AurelienCapron/autonomous-ir-projector-remote/docs/presentation_slides.pdf

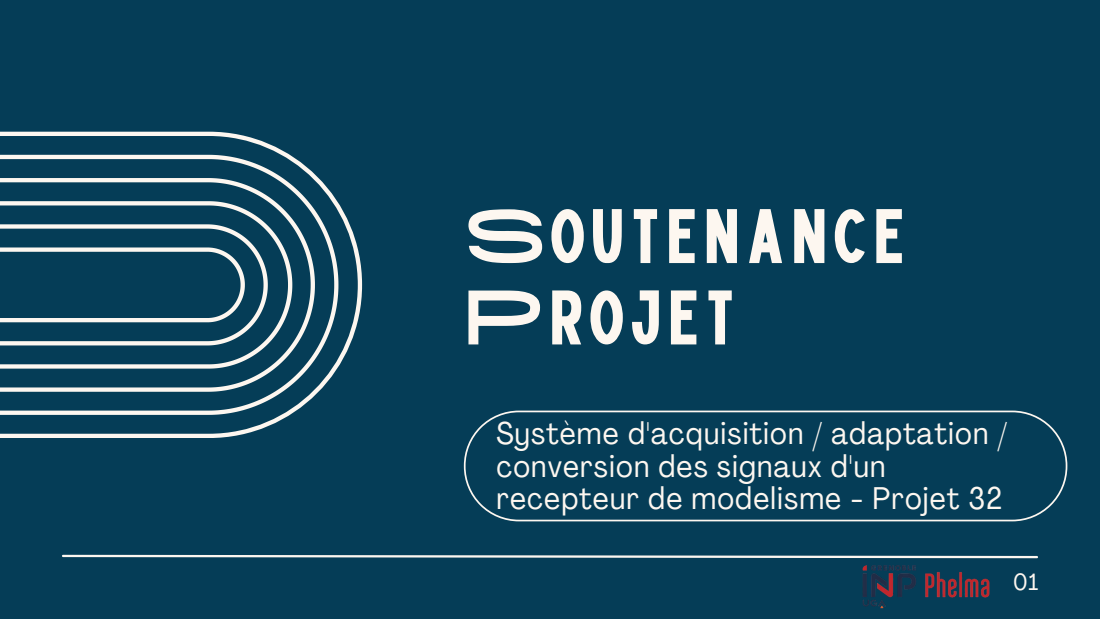
[picture p20: page 1]
Soutenance Projet

Système d'acquisition / adaptation /
conversion des signaux d'un
recepteur de modelisme - Projet 32

# Sommaire

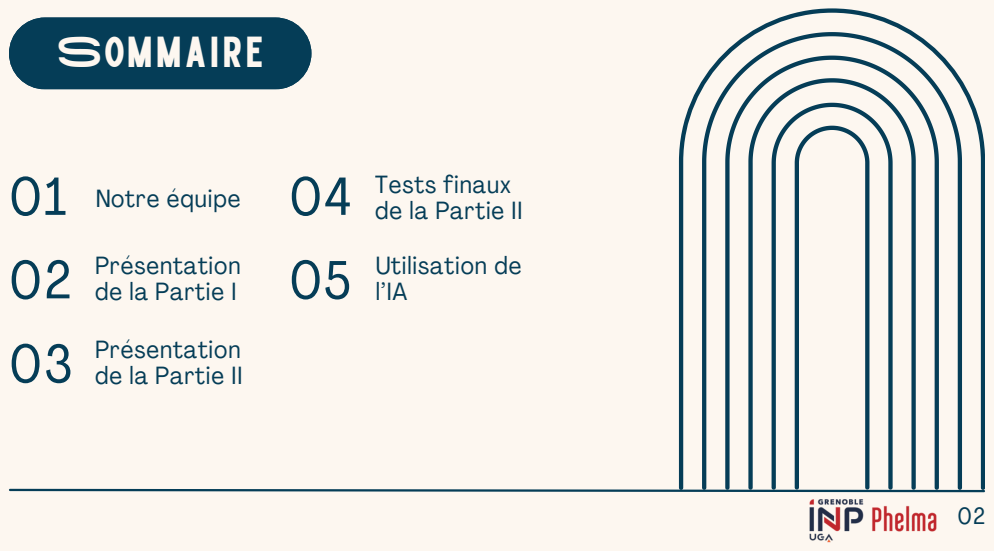
[picture p21: page 2]
Notre équipe; Tests finaux; Utilisation de l’IA

de la Partie II

Présentation
de la Partie I

# Notre équipe partie I

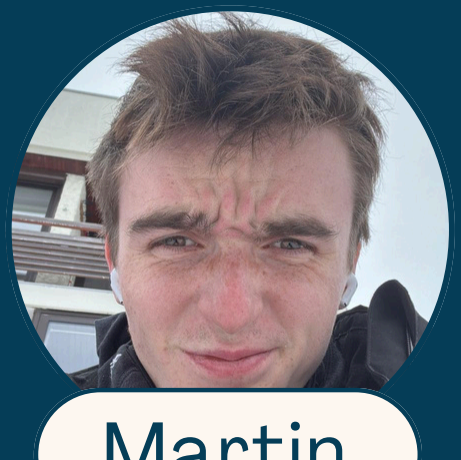
[picture p22: figure]
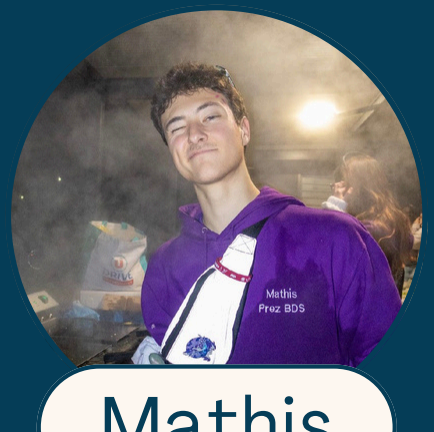
[picture p23: figure]
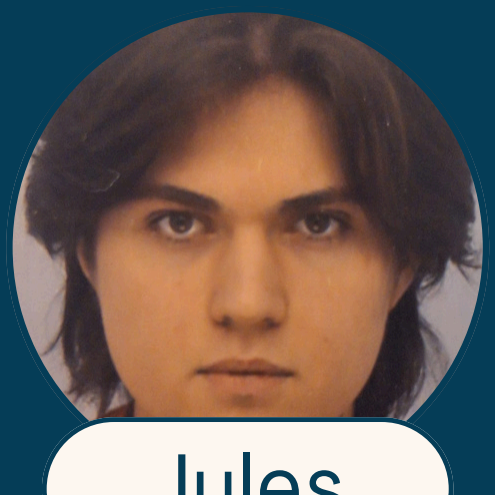
[picture p24: figure]
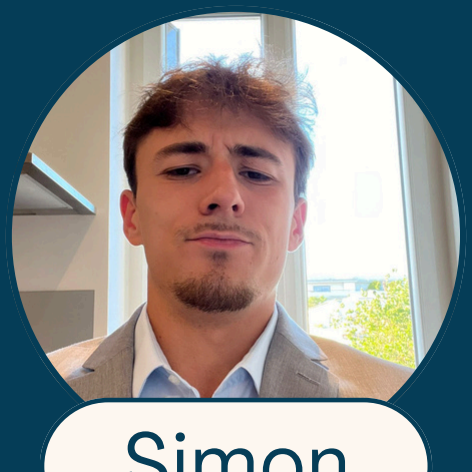
[picture p25: figure]

Martin | Mathis | Jules | Simon

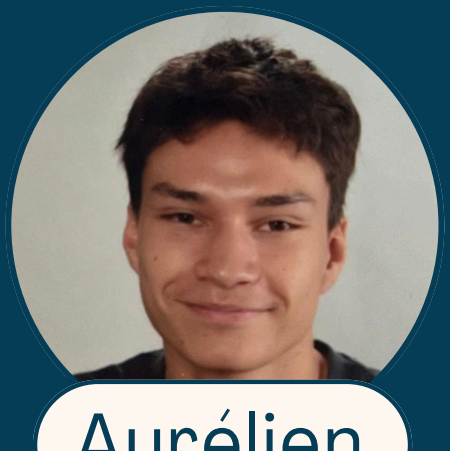
[picture p26: figure]
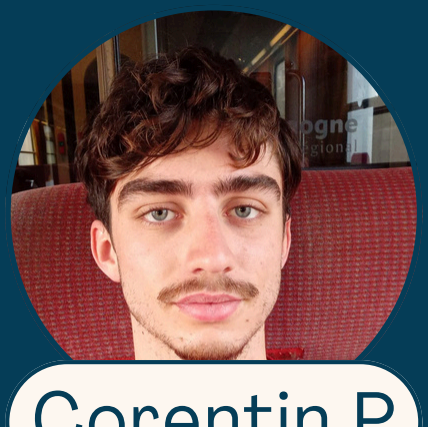
[picture p27: figure]
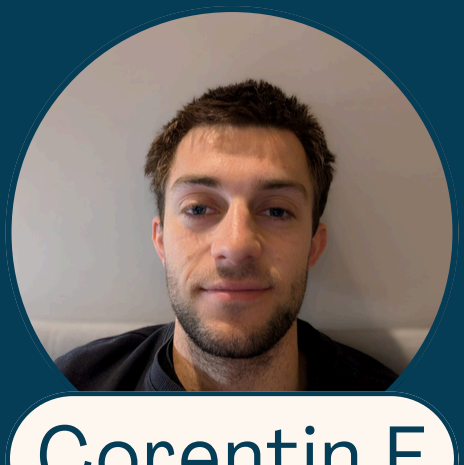
[picture p28: figure]
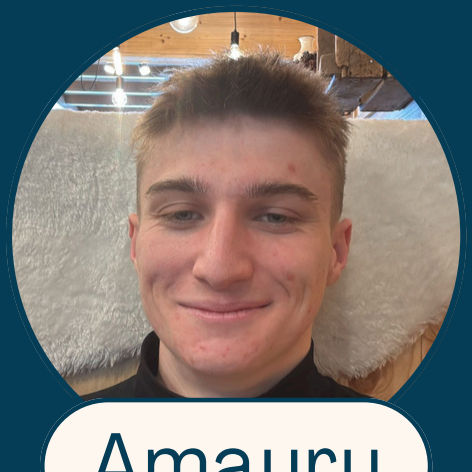
[picture p29: figure]
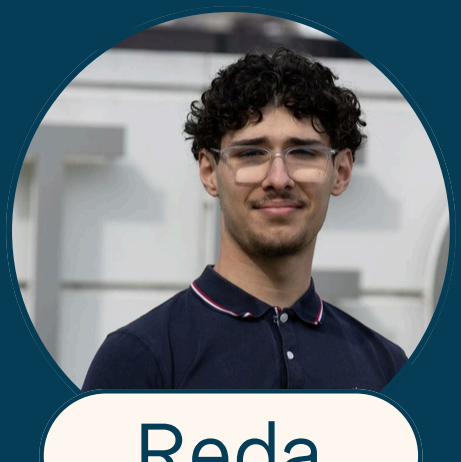
[picture p30: figure]

Aurélien | Corentin P | Corentin E | Amaury | Reda

# Notre équipe partie II

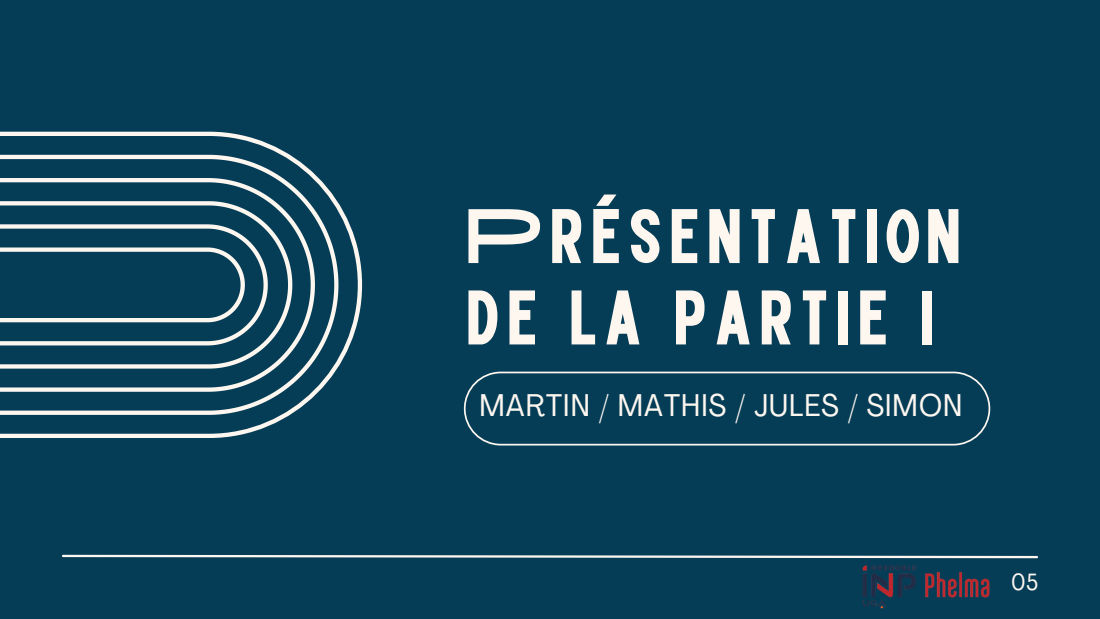
[picture p31: page 5]

Présentation
de la partie I

MARTIN / MATHIS / JULES / SIMON

# Contexte

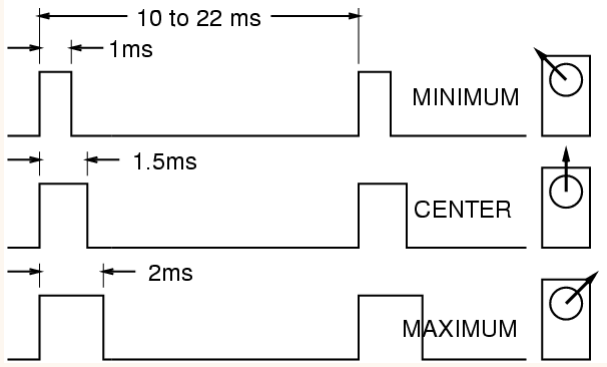
[picture p32: figure]

6

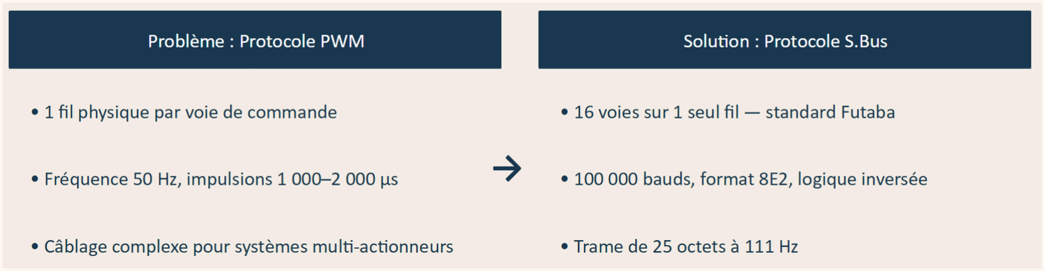
[picture p33: figure]

# Cahier des charges

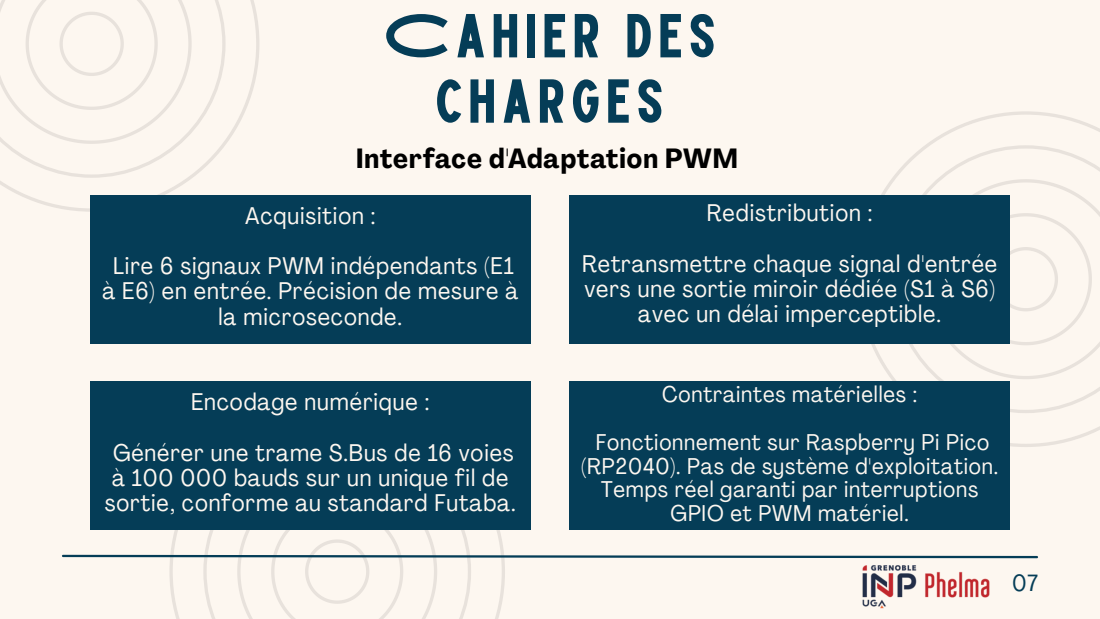
[picture p34: page 7]
Encodage numérique :; Contraintes matérielles :; Acquisition :; la microseconde.; Redistribution :

Interface d'Adaptation PWM

Retransmettre chaque signal d'entrée
vers une sortie miroir dédiée (S1 à S6)
avec un délai imperceptible.

Lire 6 signaux PWM indépendants (E1
à E6) en entrée. Précision de mesure à

Fonctionnement sur Raspberry Pi Pico
(RP2040). Pas de système d'exploitation.
Temps réel garanti par interruptions

Générer une trame S.Bus de 16 voies
à 100 000 bauds sur un unique fil de
sortie, conforme au standard Futaba.

GPIO et PWM matériel.

# Points clés du code :

Interruptions GPIO : attachInterrupt() déclenché sur chaque changement d'état (CHANGE). Mesure de la durée impulsion via micros(). Filtrage des valeurs hors plage [1000 ; 2000] µs.

Une callback par voie : Arduino n'autorise pas de paramètres dans les callbacks d'interruption. Une fonction dédiée par voie (callback_voie_0, callback_voie_1, callback_voie_2) contourne cette contrainte.

Sorties servo : Bibliothèque Servo.h avec writeMicroseconds() pour piloter directement en µs. Signal PWM 50 Hz généré en hardware, sans charge CPU.

Encodage S.Bus : Conversion linéaire PWM→11 bits par voie, empilement bit à bit sur 25 octets, inversion logique ~trame[i] et envoi Serial1 à 100 000 bauds 8E2.

8

# Explication du code :

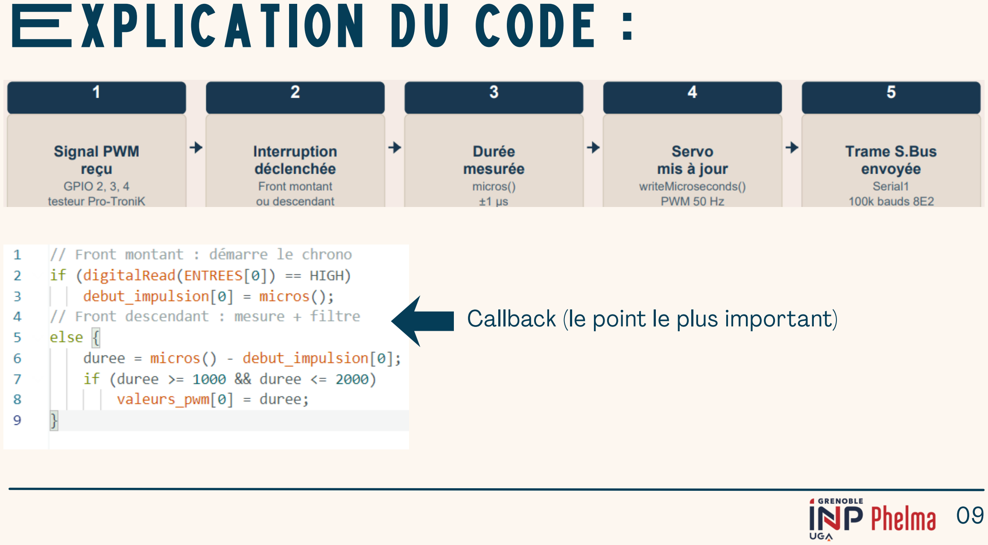
[picture p35: page 9]

Callback (le point le plus important)

9

# architecture de l’expérience

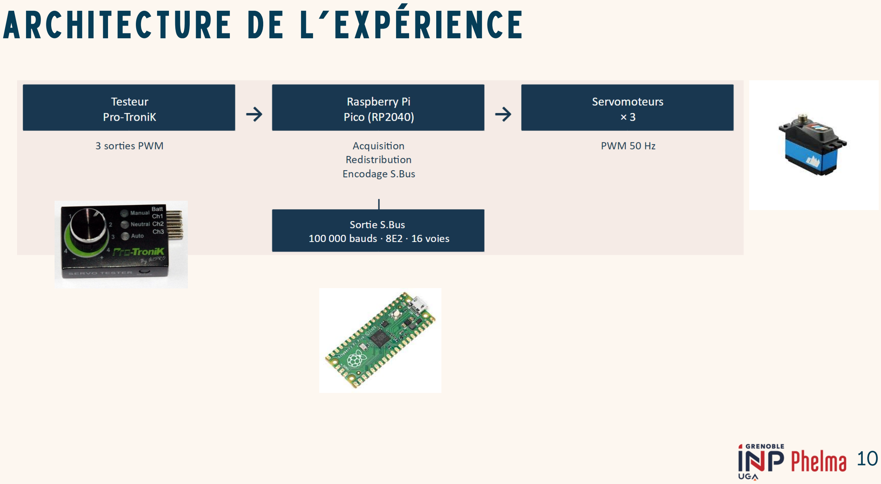
[picture p36: page 10]

10

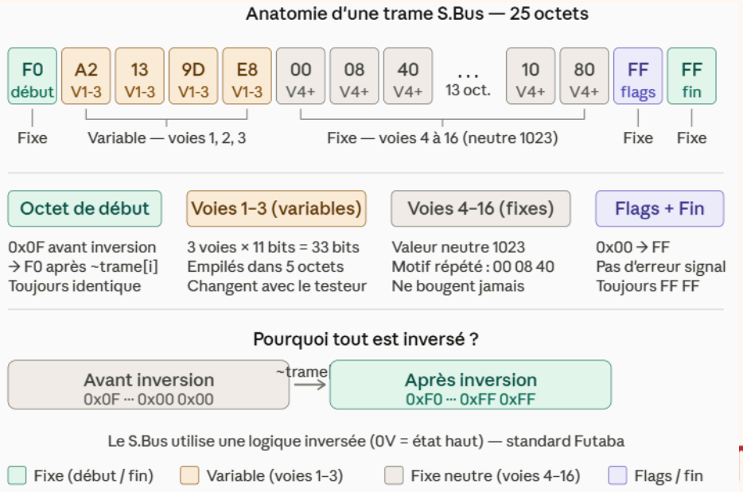
[picture p37: figure]

Étape | Action / Opération | Illustration Binaire / Hexa | Valeur Décimale
1. Poids faible (8 bits) | Lecture de l'Octet 1 | 0x5D | 93
2. Poids fort (3 bits) | Extraction sur l'Octet 2 | 1110 1100 → on garde 100 | 4
3. Alignement | Décalage à gauche (<< 8) | Multiplication par 28 (4* 256) | 1024
4. Résultat Voie 1 | Fusion des deux parties | | 93 + 1024 = 1117

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
# uin

o

V

ale

u

r

minim

ale : Valeur neutre : Valeur maximale : | 1

1

# vérification des résultats

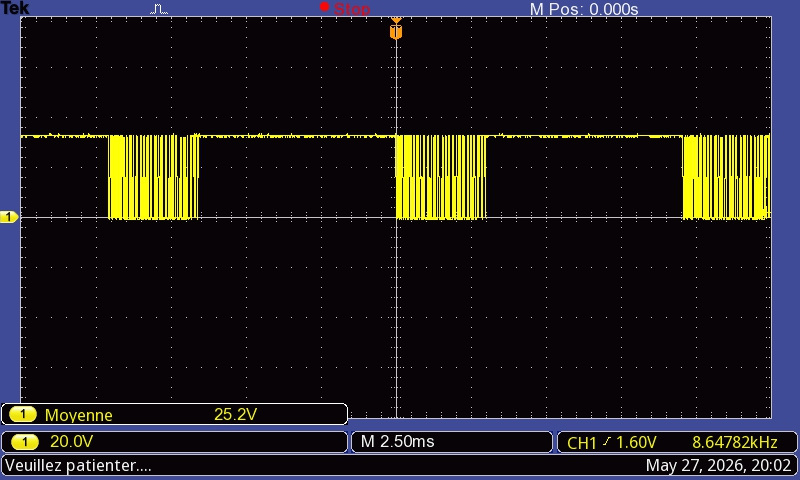
[picture p38: figure]
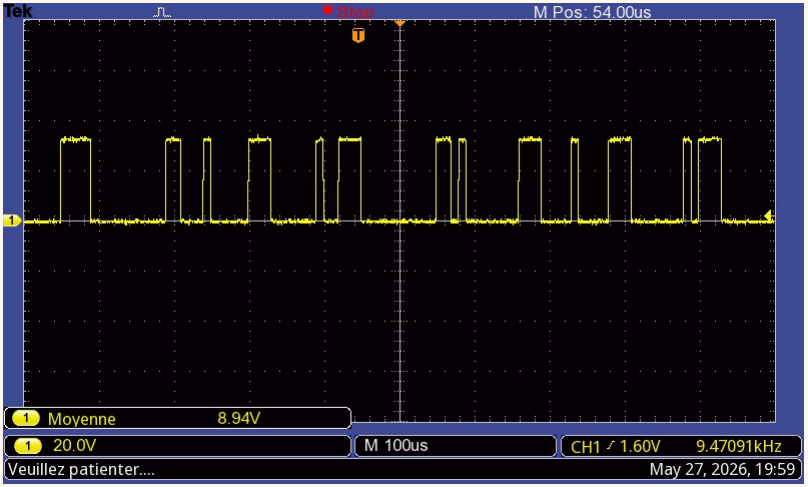
[picture p39: figure]

Points clés :
Base de temps oscilloscope : 100 µs / division Configuration matérielle (Pico) : UART S.Bus à 100 000 bauds Preuves mathématiques :
Durée d'un bit sur la ligne : 1/100000 = 10 µs Durée totale d'un octet S.Bus : 12 bits × 10 µs = 120 µs
L'encodage matériel du microcontrôleur est parfaitement aligné sur la norme.

Points clés :
Base de temps oscilloscope : 2,50 ms / division Observations physiques :
Espacement entre deux trames : environ 3,6 divisions Largeur d'un bloc de données : environ 1,2 divisions Preuves mathématiques :
Période de rafraîchissement mesurée : 3,6 div × 2,5 ms/div = 9 ms (Conforme au standard)
Temps de transmission théorique (25 octets, format 8E2 = 12 bits/octet) : (25*12)/100000 = 3ms (Correspond à la largeur d'1,2 division mesurée à l'écran)

12

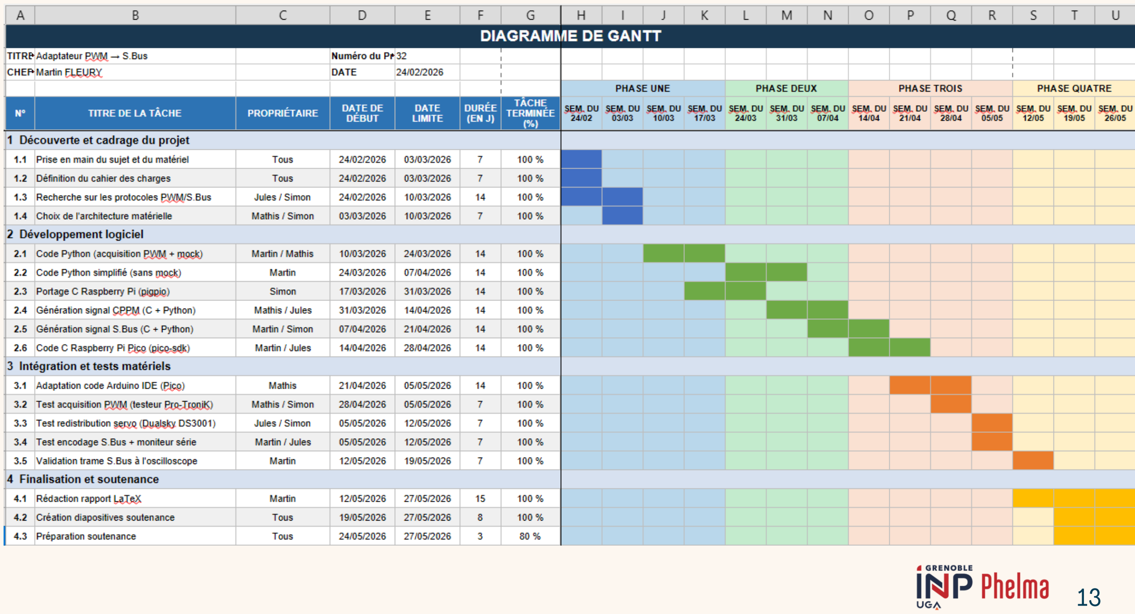
[picture p40: page 13]

13

# conclusion partie 1 :

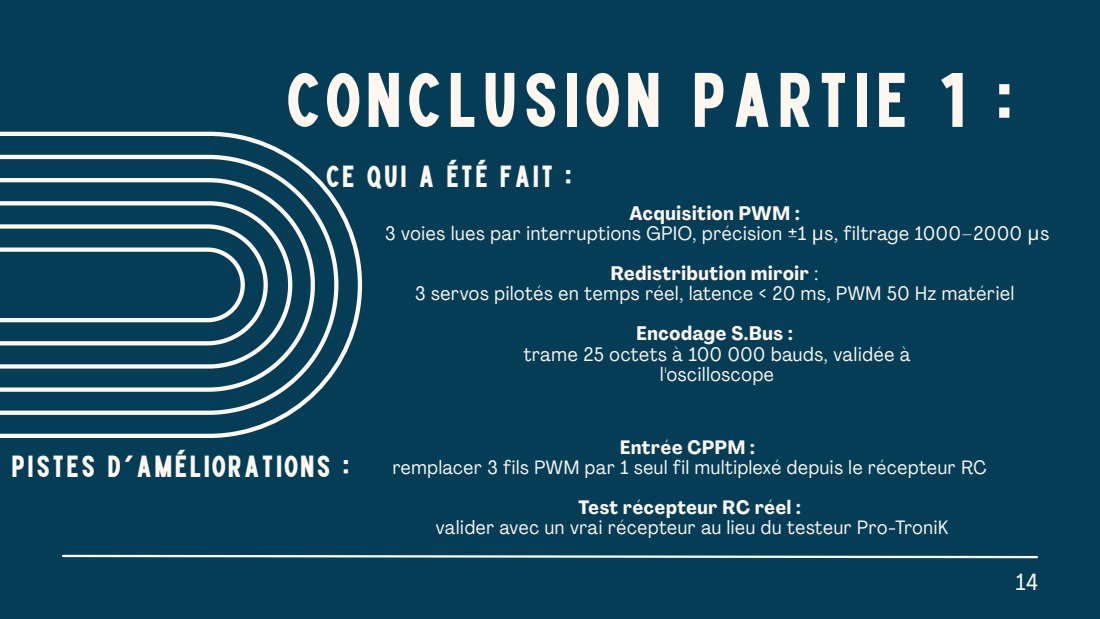
[picture p41: page 14]
Acquisition PWM :; Redistribution miroir :; Encodage S.Bus :; l'oscilloscope; pistes d’améliorations :; Entrée CPPM :

ce qui a été fait :

3 voies lues par interruptions GPIO, précision ±1 µs, filtrage 1000–2000 µs

3 servos pilotés en temps réel, latence < 20 ms, PWM 50 Hz matériel

trame 25 octets à 100 000 bauds, validée à

remplacer 3 fils PWM par 1 seul fil multiplexé depuis le récepteur RC

Test récepteur RC réel :

valider avec un vrai récepteur au lieu du testeur Pro-TroniK

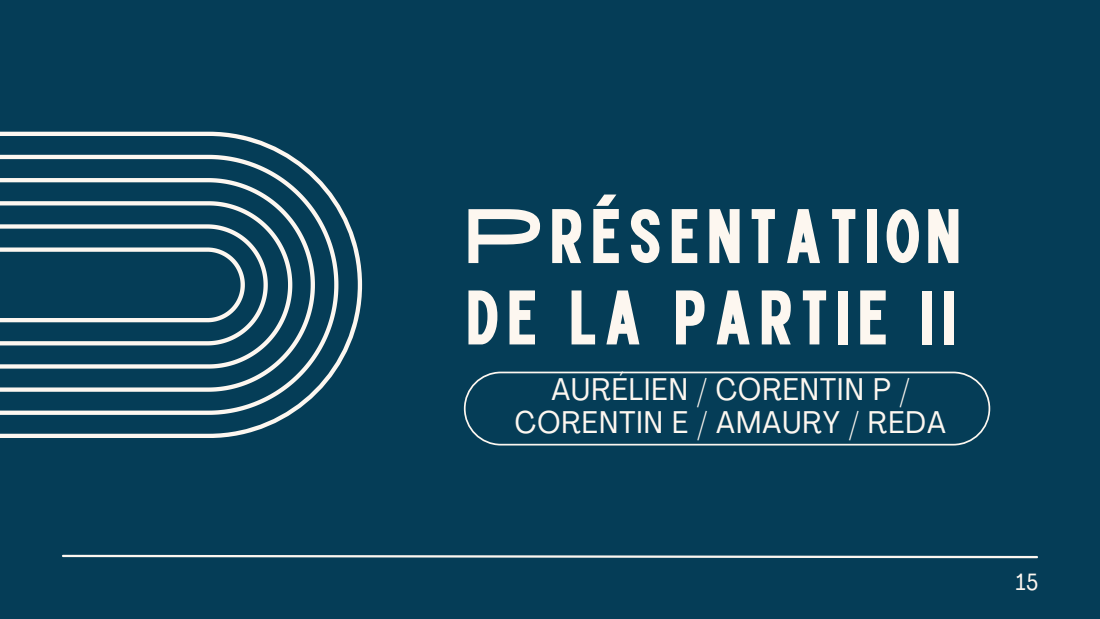
[picture p42: page 15]

Présentation
de la partie II

AURÉLIEN / CORENTIN P /
CORENTIN E / AMAURY / REDA

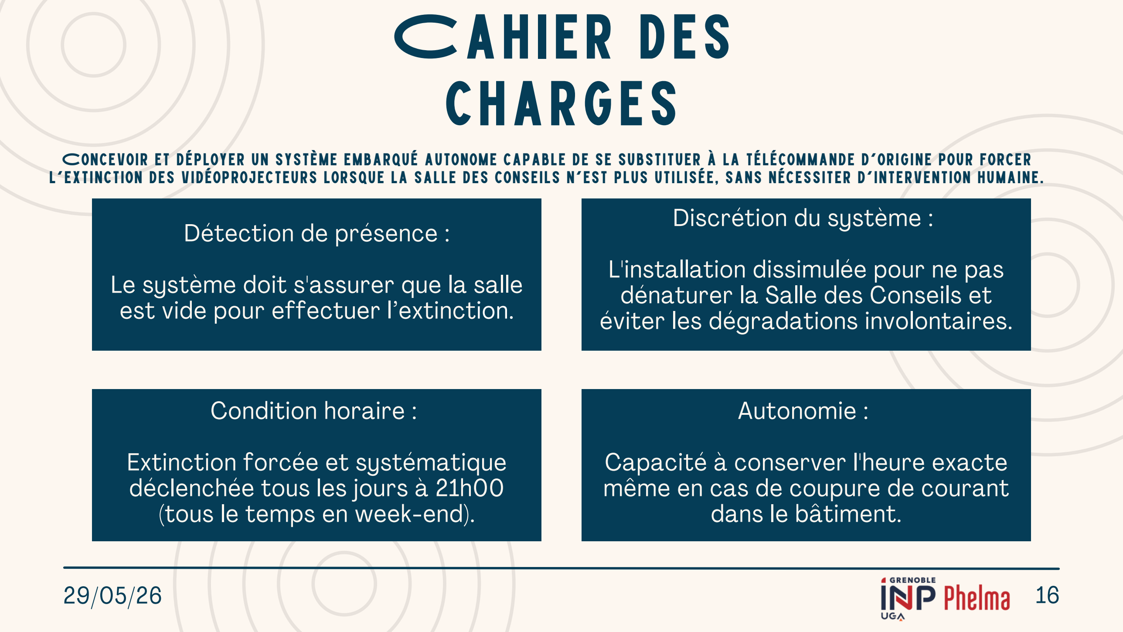
[picture p43: figure]
Condition horaire :; Extinction forcée et systématique déclenchée tous les jours à 21h00 (tous le temps en week-end).; Cahier des charges; Autonomie :; Capacité à conserver l'heure exacte même en cas de coupure de courant dans le bâtiment.; Détection de présence :; Le système doit s'assurer que la salle est vide pour effectuer l’extinction.; Discrétion du système :; L'installation dissimulée pour ne pas dénaturer la Salle des Conseils et éviter les dégradations involontaires.

Concevoir et déployer un système embarqué autonome capable de se substituer à la télécommande d'origine pour forcer l'extinction des vidéoprojecteurs lorsque la salle des conseils n'est plus utilisée, sans nécessiter d'intervention humaine.

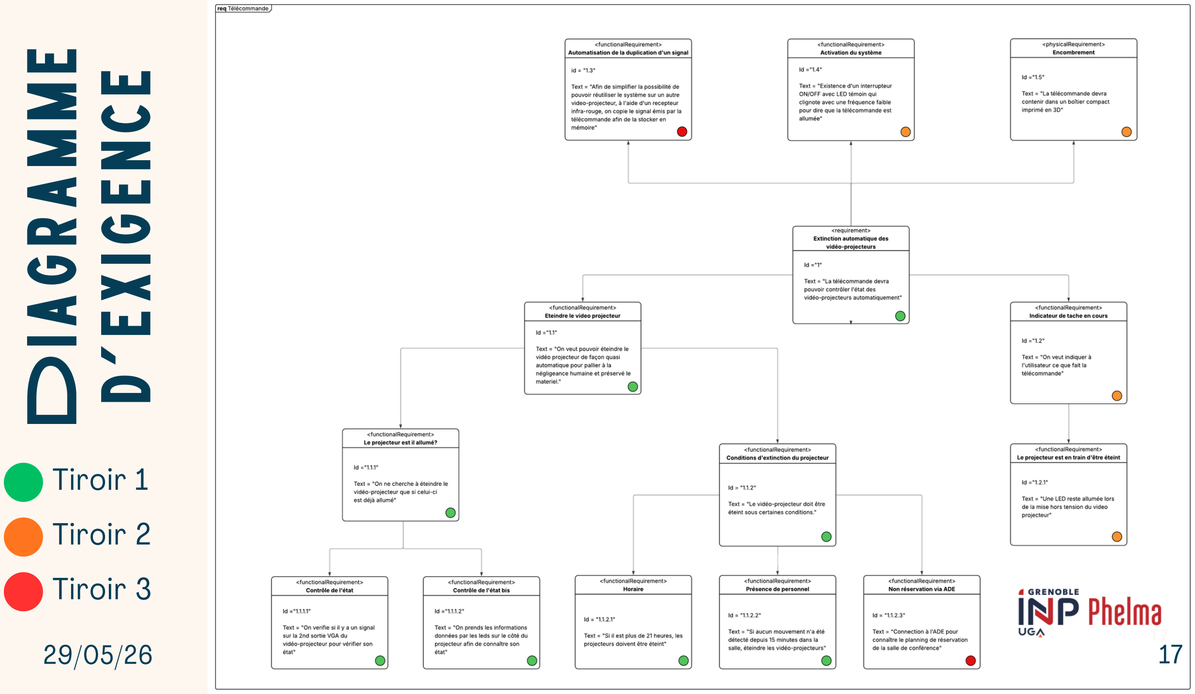
[picture p44: page 17]

# Diagramme d’exigence

/

/

### Tir

### oir

1

### Tir

### oir

2

### Tir

### oir

3

1

7

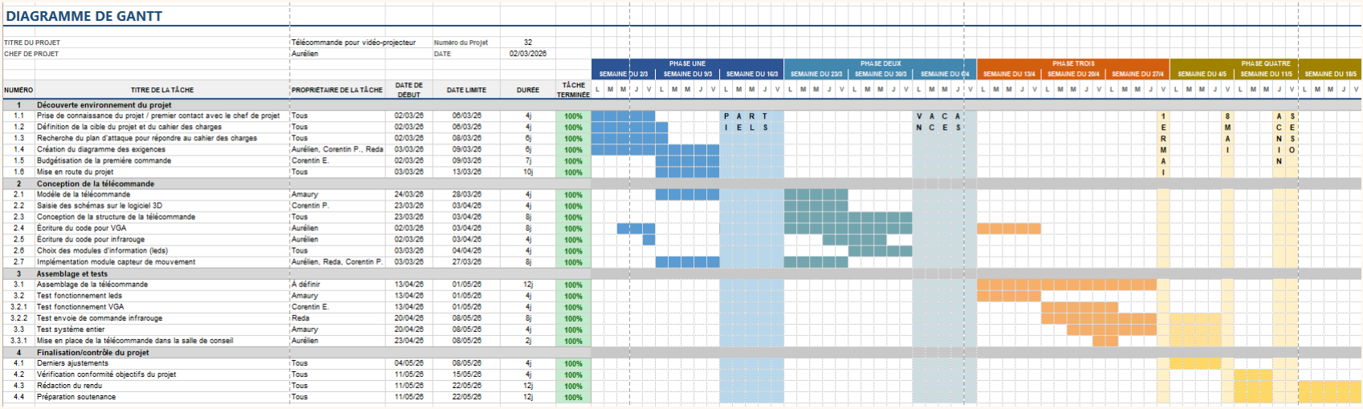
[picture p45: figure]

29/05/26 | 18
| 18

# circuit électronique

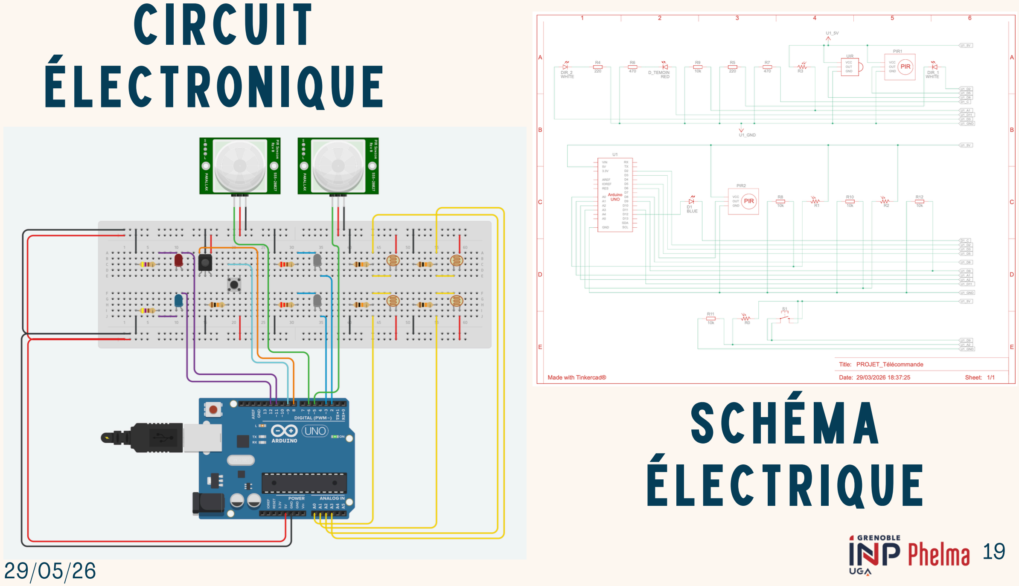
[picture p46: page 19]

29/05/26

# schéma électrique

19

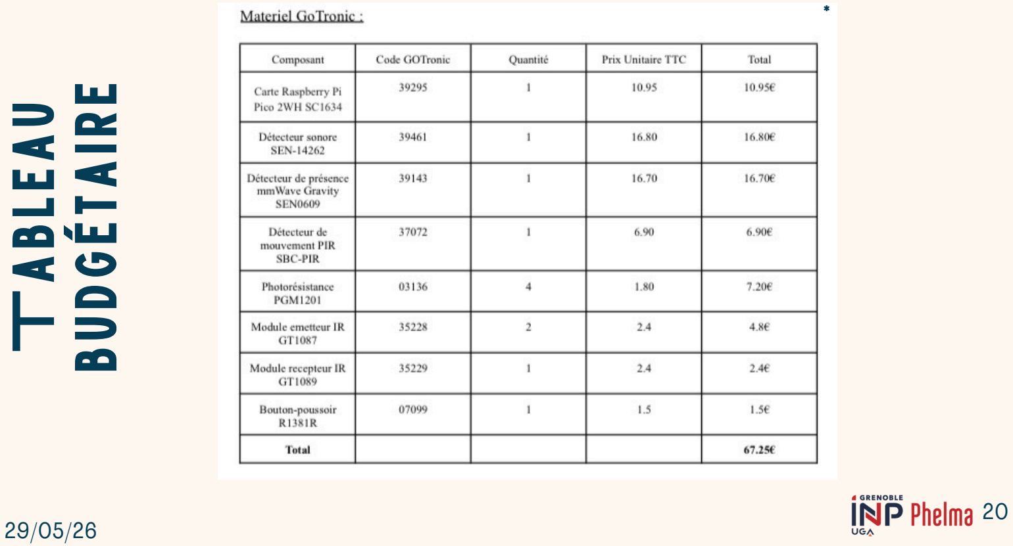
[picture p47: page 20]

/

/

# Tableau

# budgétaire

*

2

0

21

# 12h/nuit

# ~2x par semaine

# 1250h/an

## prix d’une lampe : ~100€ - 200€ vie totale de la lampe : 3000h-4000h → 33% de la lampe consumé sans intérêt

29/05/26

# Dégradation du matériel

# acquisition de l’état du vidéo-projecteur

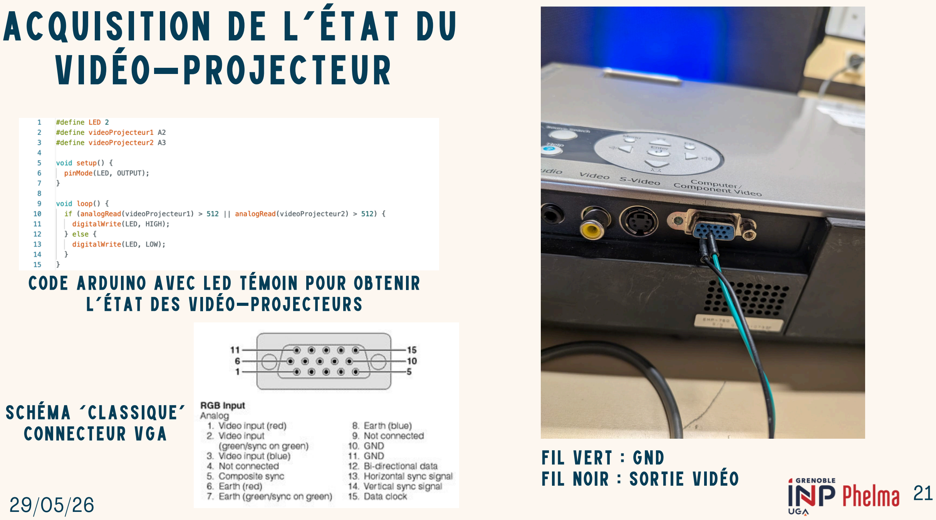
[picture p48: page 22]

21 29/05/26

### code arduino avec led témoin pour obtenir l’état des vidéo-projecteurs

### fil vert : gnd fil noir : sortie vidéo

### schéma ‘classique’ connecteur vga

22

# protocole nec

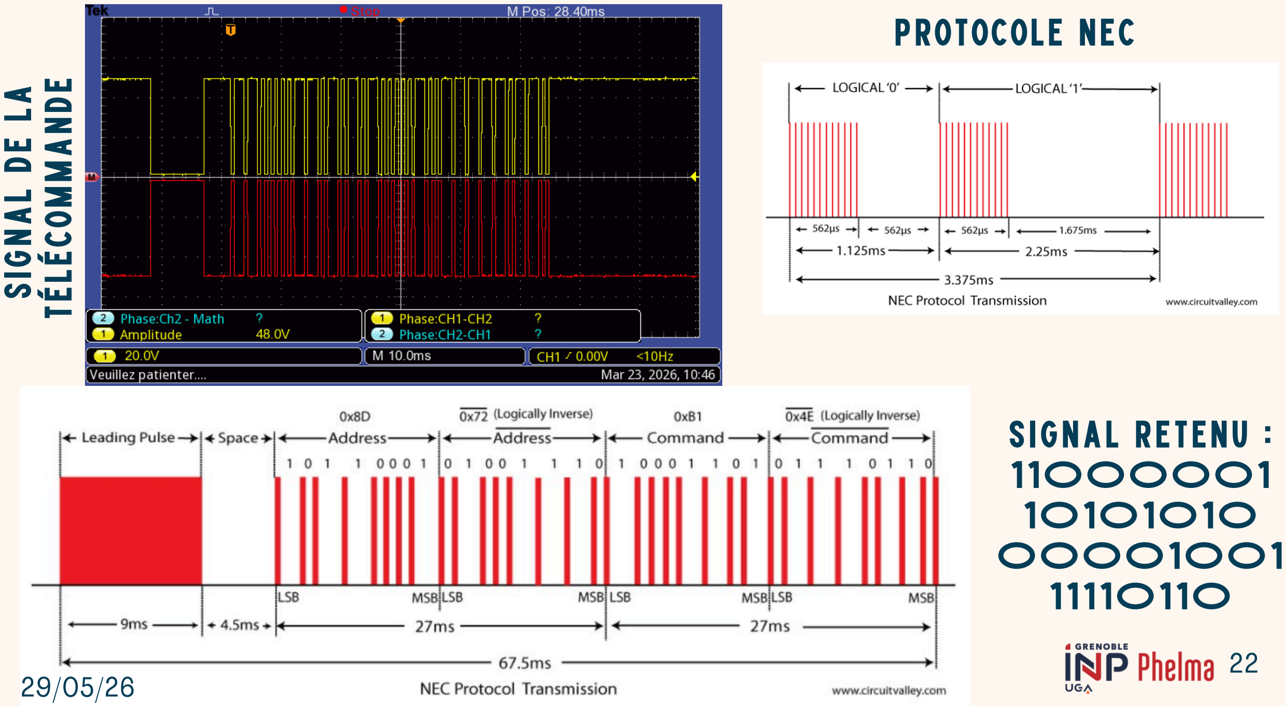
[picture p49: page 23]

29/05/26

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
# signal retenu :

11000001
10101010
00001001
11110110

23

# Conversion du signal en hexadécimal

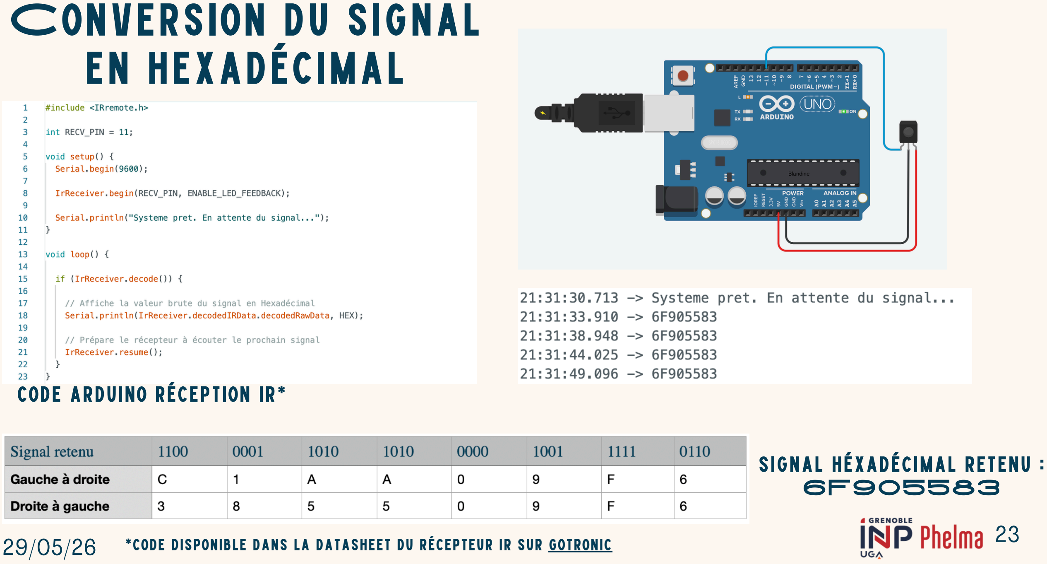
[picture p50: page 24]

23 29/05/26

### code arduino réception ir*

*code disponible dans la datasheet du récepteur ir sur gotronic (https://www.gotronic.fr/pj2-35229-2277.pdf)

### signal héxadécimal retenu :

6F905583
24

Blandine

# Reproduction du signal retenu hexadécimal

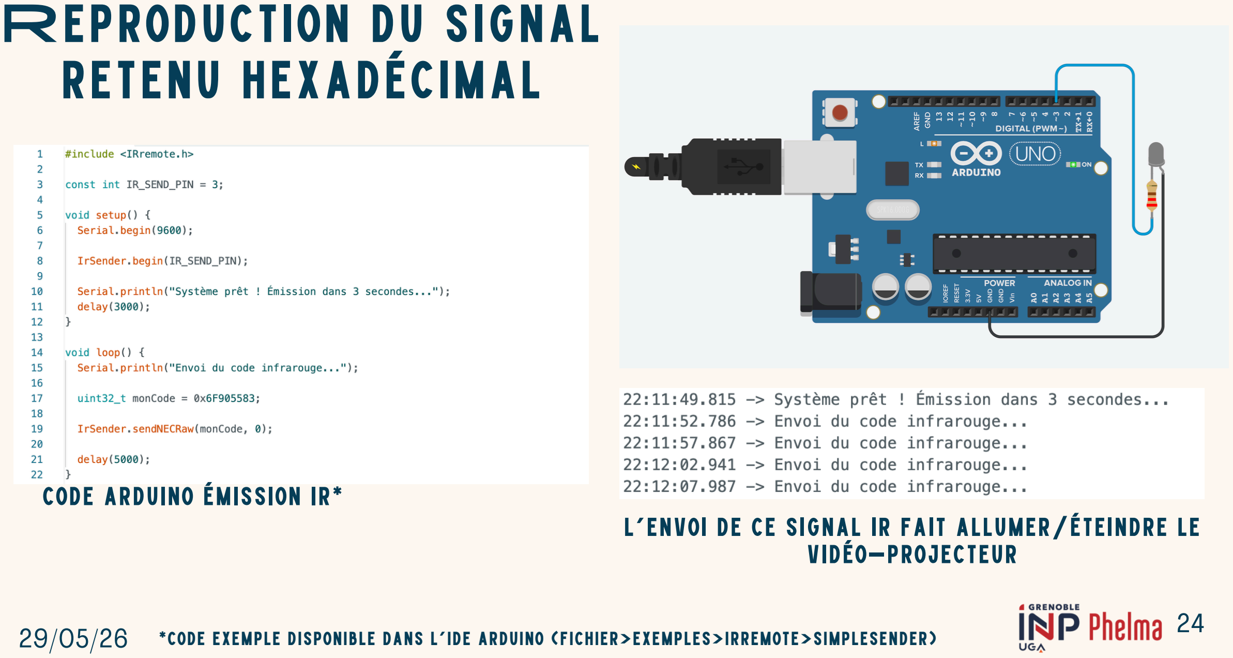
[picture p51: page 25]

24 29/05/26

### code arduino émission ir*

*code exemple disponible dans l’ide arduino (fichier>exemples>irremote>simplesender)

### l’envoi de ce signal ir fait allumer/éteindre le vidéo-projecteur

25

# Reconstruction des bits nec

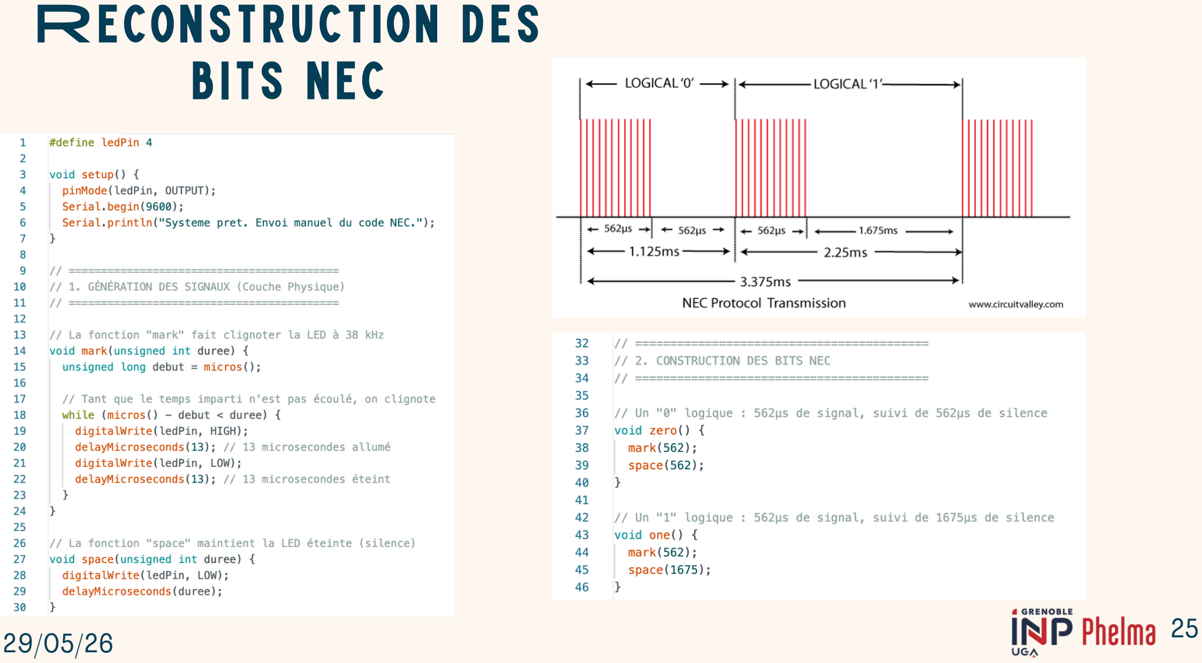
[picture p52: page 26]

29/05/26

26

# Reproduction du signal retenu hexadécimal

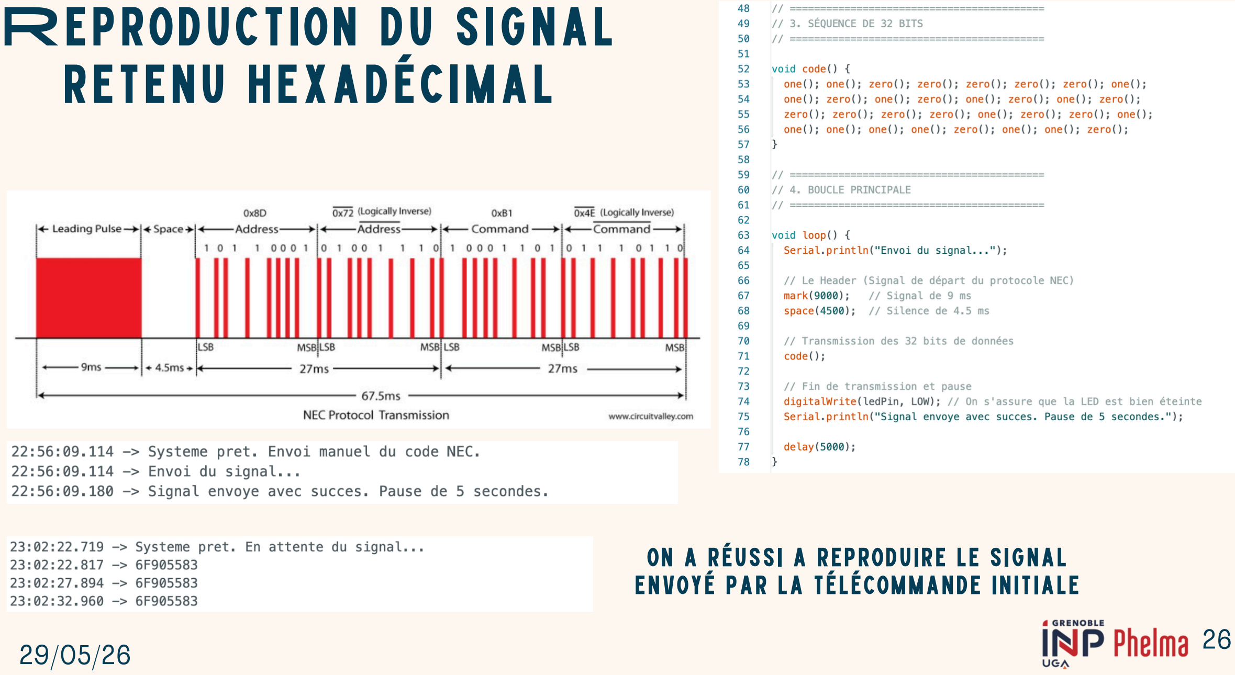
[picture p53: page 27]

29/05/26

### on a réussi a reproduire le signal envoyé par la télécommande initiale

27

Idée n°1 : | Idée n°2 :

# Mise en forme du système

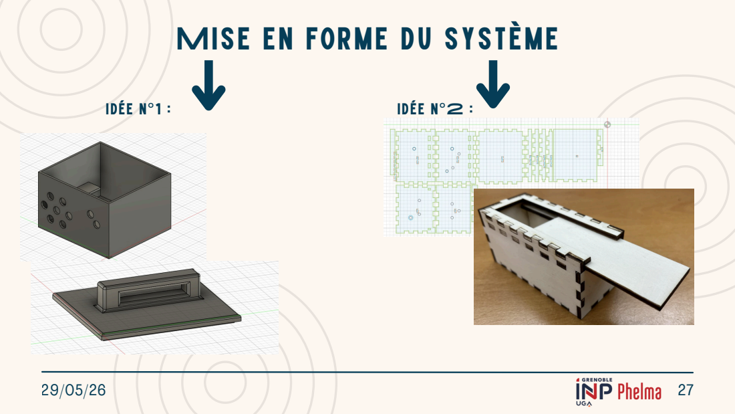
[picture p54: page 28]

# Mise en forme du système

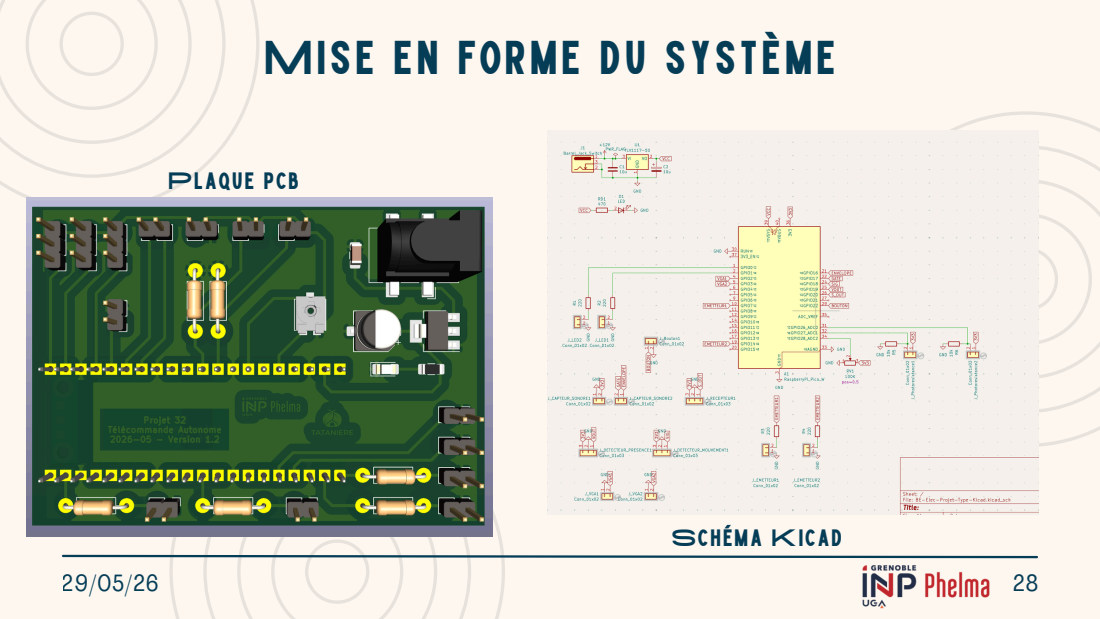
[picture p55: page 29]
Plaque pcb; Schéma Kicad

# Résultat final

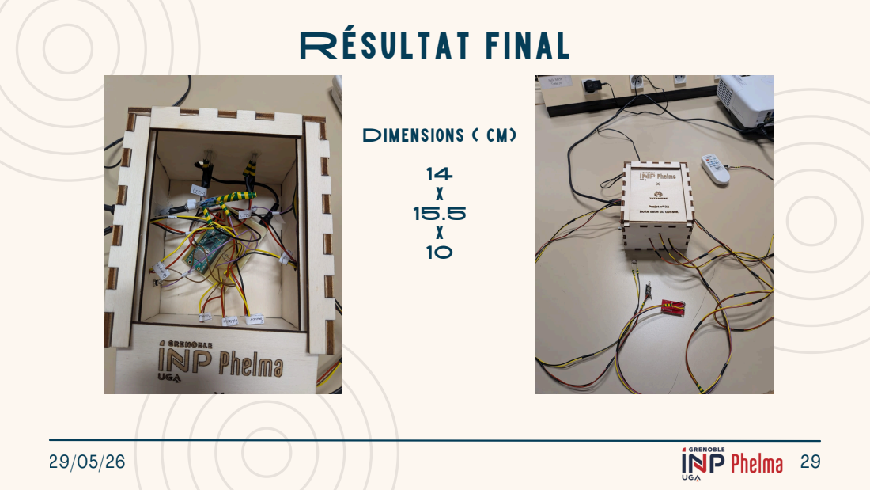
[picture p56: page 30]
Dimensions ( cm)

# tests et resultats

## Objectifs :

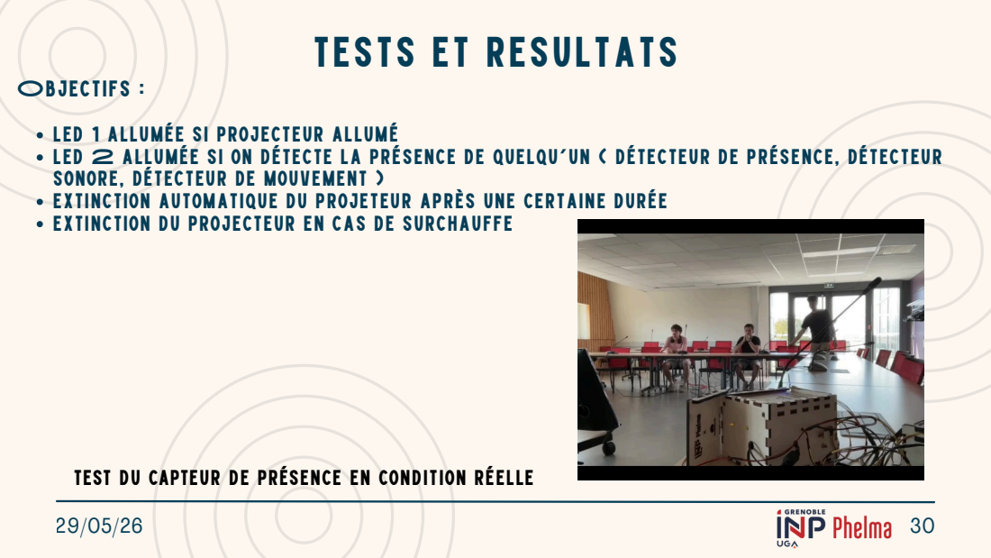
[picture p57: page 31]

led 1 allumée si projecteur allumé
led 2 allumée si on détecte la présence de quelqu’un ( détecteur de présence, détecteur
sonore, détecteur de mouvement )
extinction automatique du projeteur après une certaine durée
extinction du projecteur en cas de surchauffe

test du capteur de présence en condition réelle

31 29/05/26

# L’IA dans notre projet

### Quelle IA ?

Pourquoi celle-là ? | Accès gratuit à Gemini Pro
| Même fonctionnalités que d’autres IA existantes ( Claude, ChatGPT, Le Chat Mistral, Deepseek )
| Pas de nécessité d’outils plus avancés

32

32 29/05/26

# L’IA dans notre projet

Pourquoi l’utilise-t-on ? | Débogage du code Arduino
| Idées supplémentaires de conditions sur l’envoi ou non du signal
| Recherche d’informations dans la doc du vidéoprojecteur et dans les docs du testeur / bibliothèques arduino

33

33 29/05/26

# L’IA dans notre projet

### Comment ?

Contexte du projet :

On explique le but du projet ainsi que le cahier des charges global

Problème que l’on rencontre :

On explique la démarche que l’on a suivi, ce que l’on souhaite faire, et le problème qui se pose à nous, ainsi que la question que l’on se pose

Idées de pistes à étudier :

On donne des idées de pistes à étudier, ainsi que des débuts d’éléments de réponses, en laissant la porte ouverte pour des nouvelles réponses

34

34 29/05/26

# L’IA dans notre projet

### Exemple :

Etat du videoprojecteur

Le but du projet est de créer un boitier capable d’éteindre sous certaines conditions deux vidéoprojecteurs placés dans une salle des conseils. En effet après les réunions les vidéoprojecteurs restent parfois allumés. Cela pose des problèmes au niveau énergétique et aussi au niveau de la lentille du vidéoprojecteur qui peut griller à cause de la surchauffe.

On souhaite connaître l’état du vidéoprojecteur à un instant t, et on ne sait pas trop comment le savoir. En effet il semble compliqué de coller un capteur qui vérifie l’état grâce aux LEDS du vidéoprojecteur. Je joins en PDF la doc de notre modèle qui est assez vétuste. As-tu des solutions en réserve pour répondre à notre besoin ?

Tu peux rechercher dans la doc des éléments de réponse, et également sur ce qui est sur le WEB pour savoir si d’autres méthodes existent. On avait pensé à connaître l’état du système via le port USB avec une possible fonctionnalité du système mais nous n’avons pas réussi à trouver d’éléments de doc pour réaliser cela.

35

35 29/05/26

# L’IA dans notre projet

Impact ecologique
(selon données de google) (https://services.google.com/fh/files/misc/measuring_the_environmental_impact_of_delivering_ai_at_google_scale.pdf)

Energie par requête textuelle médiane :

0.24 Wh ⟶ 0.03 Wh pour une recherche classique sur le web ( 8x supérieur )

Équivalent au fonctionnement d’un micro-onde pendant une seconde

Carbone :

0.03g de CO2

Eau :

0.26 mL

Équivalent à 5 gouttes d’eau douce

36

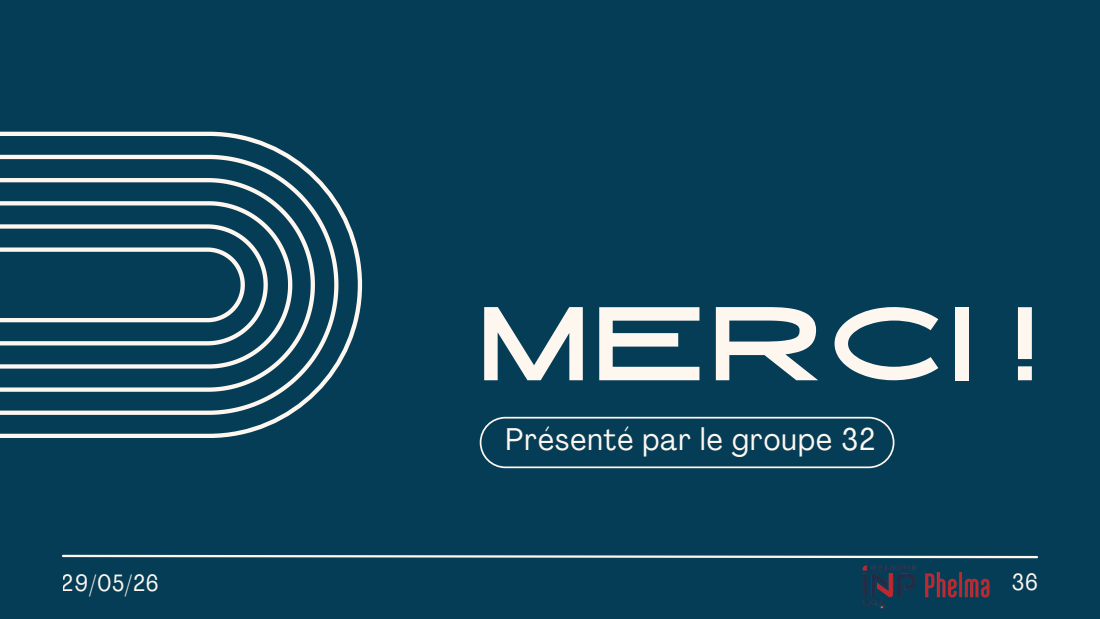
[picture p58: page 37]
MERCI !

Présenté par le groupe 32

# annexe : code complet (1/3)

38

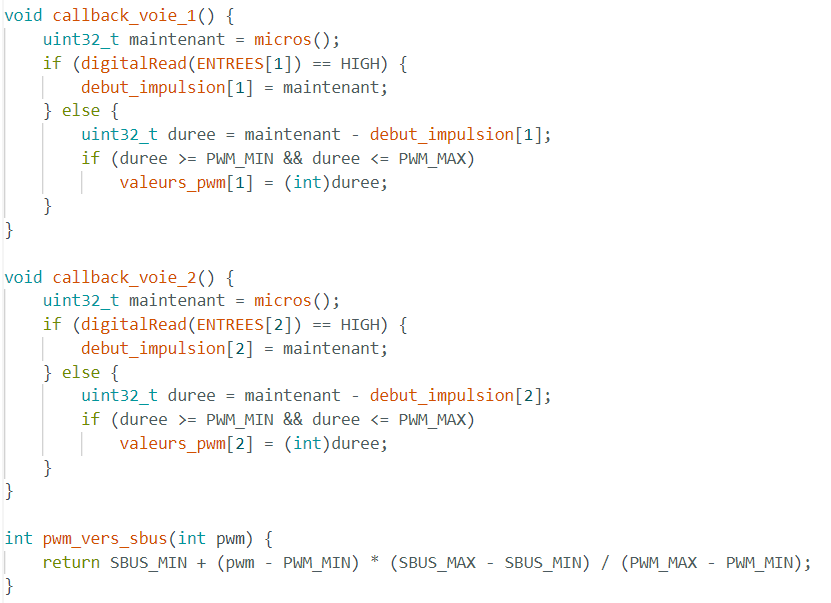
[picture p59: figure]

# annexe : code complet (2/3)

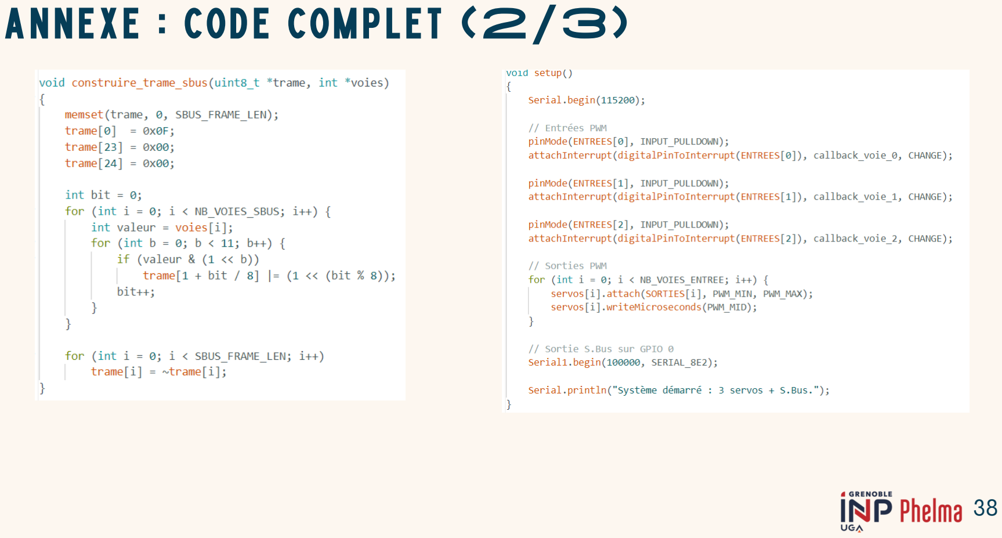
[picture p60: page 39]

39

# annexe : code complet (3/3)

40

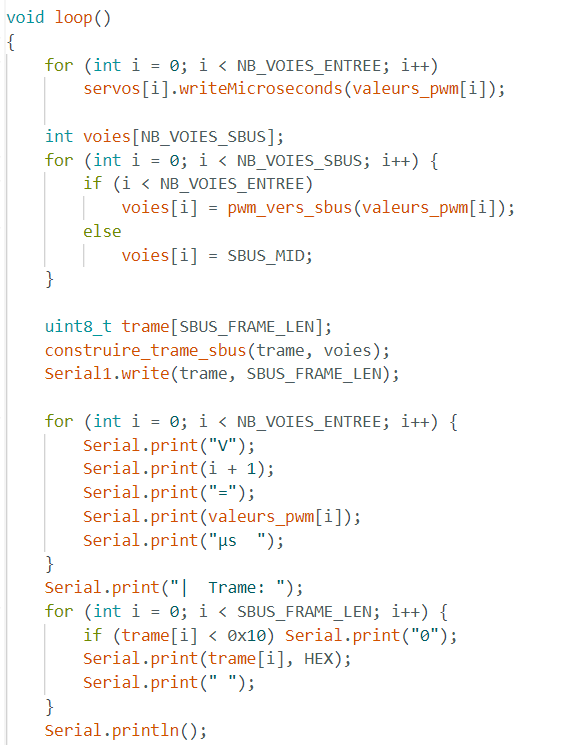
[picture p61: figure]

# annexe : console arduino

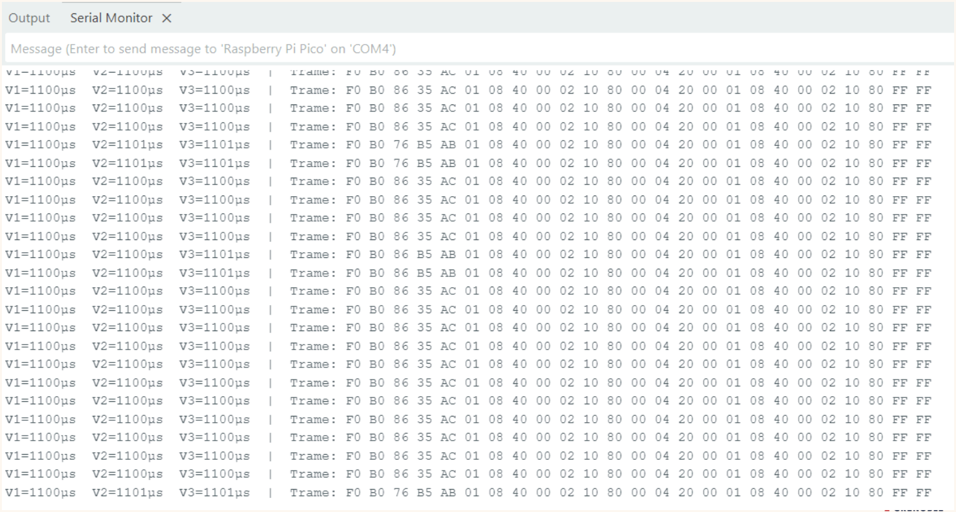
[picture p62: figure]

41

42

# annexe : sources partie 1

Documentation Sbus : https://opentx-doc.fr/wiki/pwm-cppm-s-bus-kesako-ee Forum arduino : https://forum.arduino.cc/t/generate-s-bus-packets-with-arduino/950346/6 Doc Testeur : https://www.r-models.eu/accessoires/967-testeur-de-servo-st-v3-protronik-de-a2pro.html

# annexe : code complet (1/3)

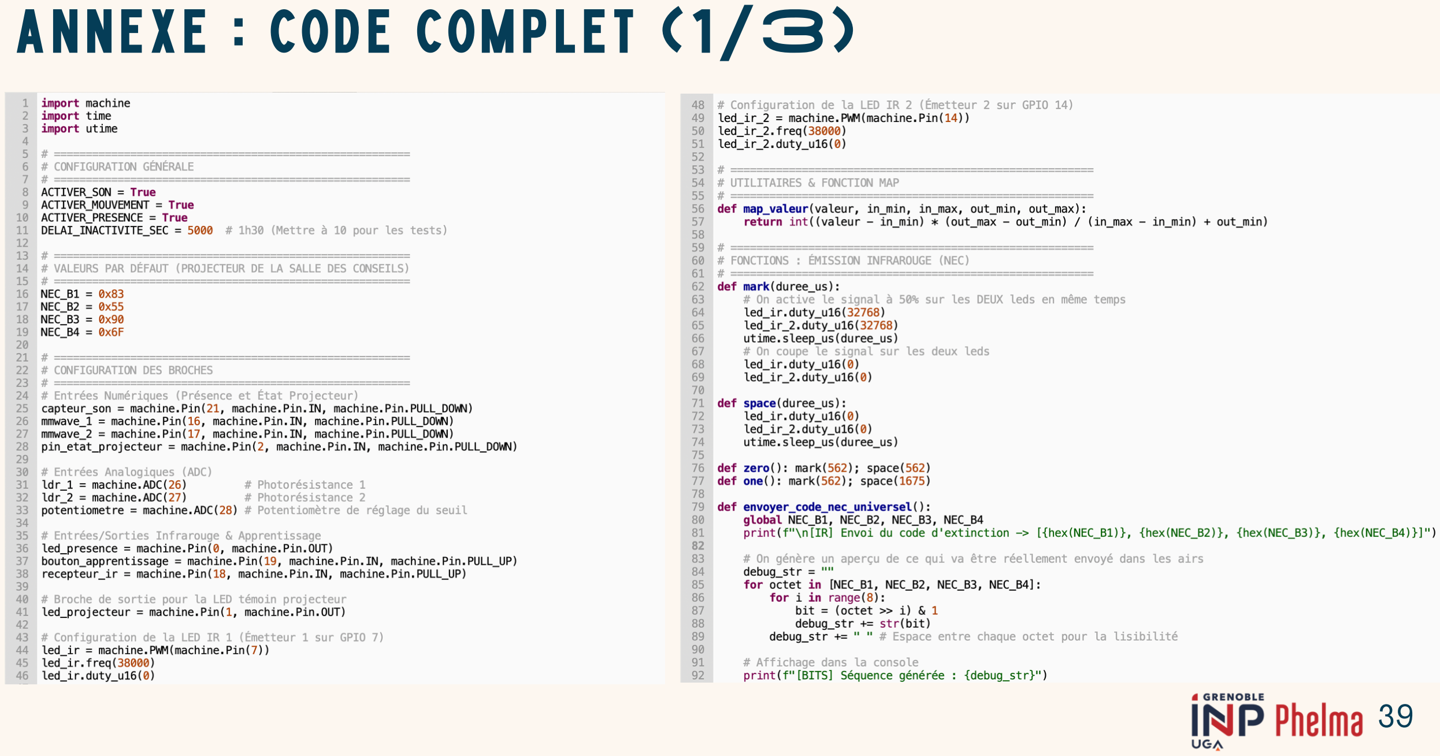
[picture p63: page 43]

43

# annexe : code complet (2/3)

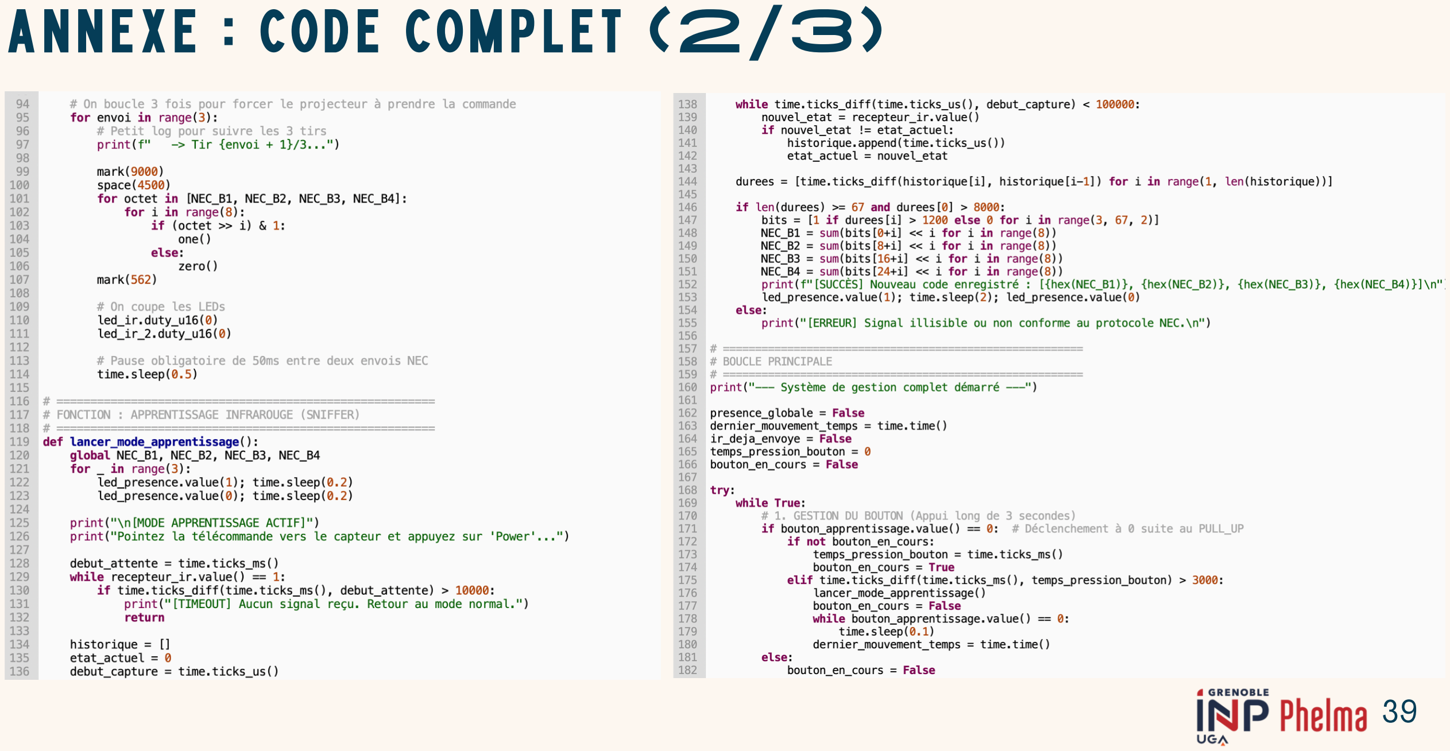
[picture p64: page 44]

44

# annexe : code complet (3/3)

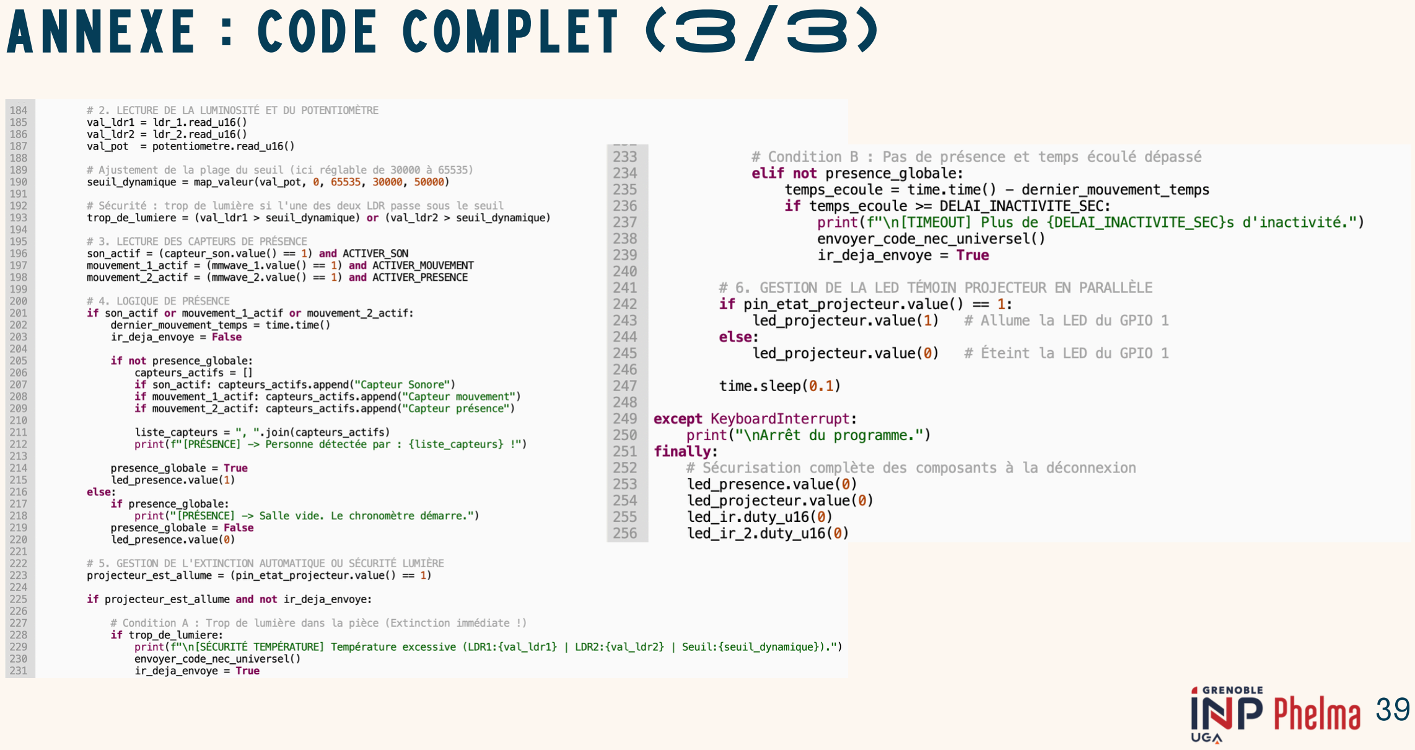
[picture p65: page 45]

45

46

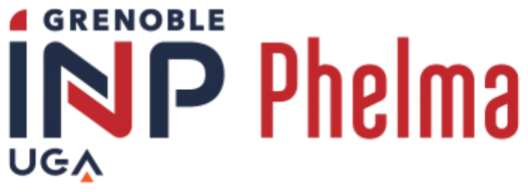
[picture p66: figure]
