AurelienCapron/autonomous-ir-projector-remote/docs/arduino_prototype_schematic.pdf

A

1 | 2 | 3 | 4 | 5 | 6

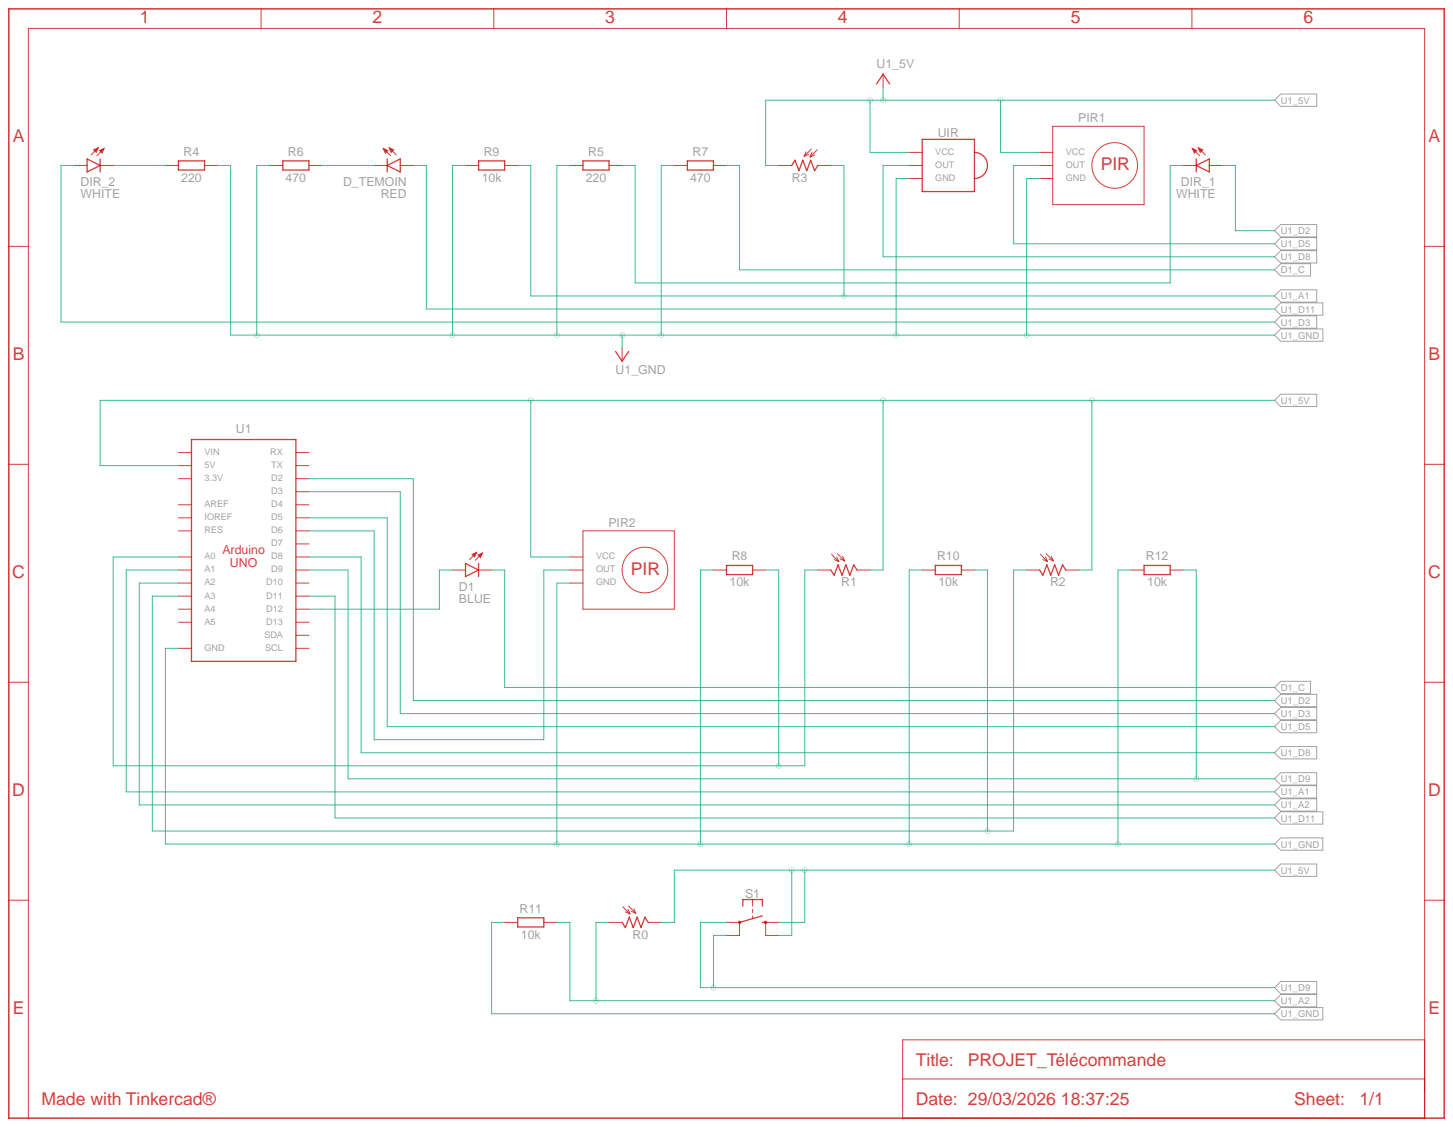
[picture p67: page 1]
