AurelienCapron/autonomous-ir-projector-remote/hardware_kicad/BE-Elec-Projet-Type-Kicad.kicad_pcb

## KiCad design hardware_kicad/BE-Elec-Projet-Type-Kicad.kicad_pcb (2026-09-28)

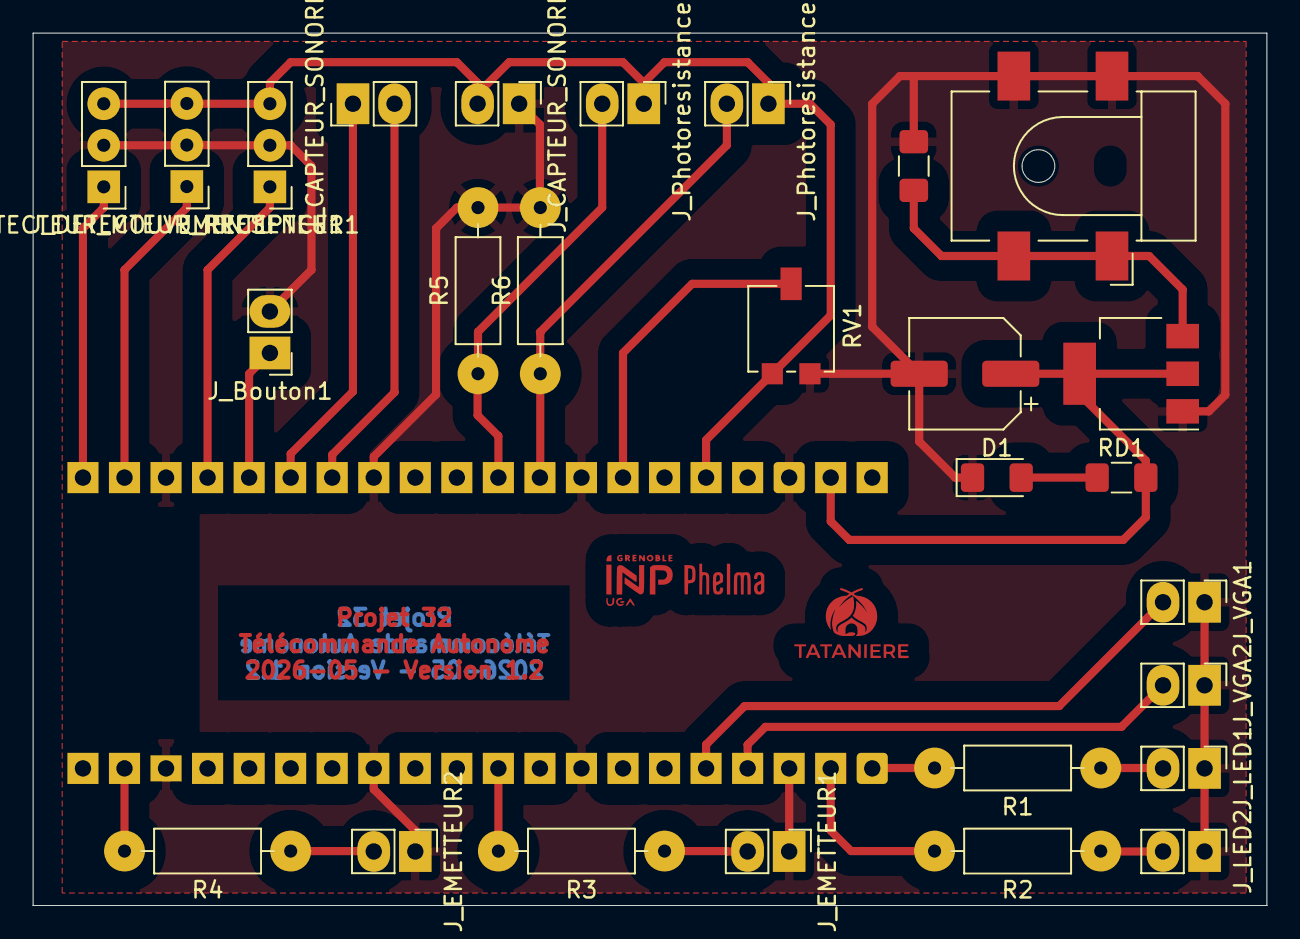
[picture p68: board BE-Elec-Projet-Type-Kicad.kicad_pcb from above]

Board: 2 copper layers, 75.4 x 53.3 mm, 29 parts (1 on the bottom side), 24 nets.

Parts:
A1: RaspberryPi_Pico_W; RaspberryPi_Pico_Common_THT
C1: 10u; C_1206_3216Metric_Pad1.42x1.75mm_HandSolder
C2: 10u; CP_Elec_6.3x5.2
D1: LED; LED_1206_3216Metric_Pad1.42x1.75mm_HandSolder
G: LOGO; tata
J1: Barrel_Jack_Switch; BarrelJack_CLIFF_FC681465S_SMT_Horizontal
J_Bouton1: Conn_01x02; PinHeader_1x02_P2.54mm_Vertical
J_CAPTEUR_SONORE1, J_CAPTEUR_SONORE2: Conn_01x02; PinHeader_1x02_P2.54mm_Vertical
J_DETECTEUR_MOUVEMENT1: Conn_01x03; PinHeader_1x03_P2.54mm_Vertical
J_DETECTEUR_PRESENCE1: Conn_01x03; PinHeader_1x03_P2.54mm_Vertical
J_EMETTEUR1, J_EMETTEUR2: Conn_01x02; PinHeader_1x02_P2.54mm_Vertical
J_LED1, J_LED2: Conn_01x02; PinHeader_1x02_P2.54mm_Vertical
J_Photoresistance1, J_Photoresistance2: Conn_01x02; PinHeader_1x02_P2.54mm_Vertical
J_RECEPTEUR1: Conn_01x03; PinHeader_1x03_P2.54mm_Vertical
J_VGA1, J_VGA2: Conn_01x02; PinHeader_1x02_P2.54mm_Vertical
R1, R2, R3, R4: 220; R_Axial_DIN0207_L6.3mm_D2.5mm_P10.16mm_Horizontal
R5, R6: 10k; R_Axial_DIN0207_L6.3mm_D2.5mm_P10.16mm_Horizontal
RD1: 470; R_1206_3216Metric_Pad1.42x1.75mm_HandSolder
RV1: 100K; Potentiometer_Vishay_TS53YL_Vertical
U1: TLV1117-50; SOT-223-3_TabPin2

Connections:
3V3: A1.36 (3V3), J_CAPTEUR_SONORE1.2, J_DETECTEUR_MOUVEMENT1.3, J_DETECTEUR_PRESENCE1.3, J_Photoresistance1.1, J_Photoresistance2.1, J_RECEPTEUR1.3, RV1.3
+12V: C1.1, J1.1, U1.3 (VI)
BOUTON: A1.25 (GPIO19), J_Bouton1.1
EMETTEUR1: A1.10 (GPIO7), R3.2
EMETTEUR2: A1.19 (GPIO14), R4.2
ENVELOPE: A1.26 (GPIO20), J_CAPTEUR_SONORE2.1
GATE: A1.27 (GPIO21), J_CAPTEUR_SONORE2.2
GND: A1.3 (GND), A1.8 (GND), A1.13 (GND), A1.18 (GND), A1.23 (GND), A1.28 (GND), A1.33 (AGND), A1.38 (GND), C1.2, C2.2, D1.1 (K), J1.2, J1.3, J_Bouton1.2, J_CAPTEUR_SONORE1.1, J_DETECTEUR_MOUVEMENT1.2, J_DETECTEUR_PRESENCE1.2, J_EMETTEUR1.1, J_EMETTEUR2.1, J_LED1.1, J_LED2.1, J_RECEPTEUR1.2, J_VGA1.1, J_VGA2.1, R5.2, R6.2, RV1.1, U1.1 (GND)
unnamed: A1.1 (GPIO0), R1.2
unnamed: A1.2 (GPIO1), R2.2
unnamed: A1.31 (GPIO26_ADC0), J_Photoresistance1.2, R5.1
unnamed: A1.32 (GPIO27_ADC1), J_Photoresistance2.2, R6.1
unnamed: A1.34 (GPIO28_ADC2), RV1.2
unnamed: D1.2 (A), RD1.1
unnamed: J_EMETTEUR1.2, R3.1
unnamed: J_EMETTEUR2.2, R4.1
unnamed: J_LED1.2, R1.1
unnamed: J_LED2.2, R2.1
SIG: A1.21 (GPIO16), J_DETECTEUR_MOUVEMENT1.1
S_OUT: A1.24 (GPIO18), J_RECEPTEUR1.1
VCC: A1.39 (VSYS), C2.1, RD1.2, U1.2 (VO)
VGA1: A1.5 (GPIO3), J_VGA1.2
VGA2: A1.4 (GPIO2), J_VGA2.2
VOUT: A1.22 (GPIO17), J_DETECTEUR_PRESENCE1.1
