AurelienCapron/autonomous-ir-projector-remote/(commit log)

2026-09-28 Ajout du PCB KiCad 9, du firmware MicroPython/C++, de la CAO et de la documentation
2026-09-28 Uniformisation de la taille des images dans les tableaux du README
2026-09-28 Correction du schéma SVG et ajout des captures du protocole NEC et oscilloscope
